libertathiest/fs10-atmega32u4-monitor/Assets/FS10-ATMEGA32U4-flyer.pdf

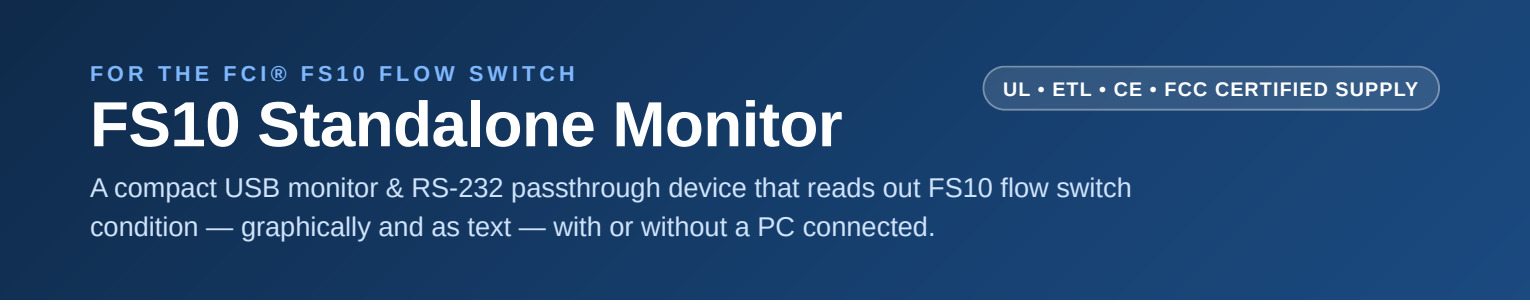
[picture p1: figure]
FS10 Standalone Monitor; UL • ETL • CE • FCC CERTIFIED SUPPLY
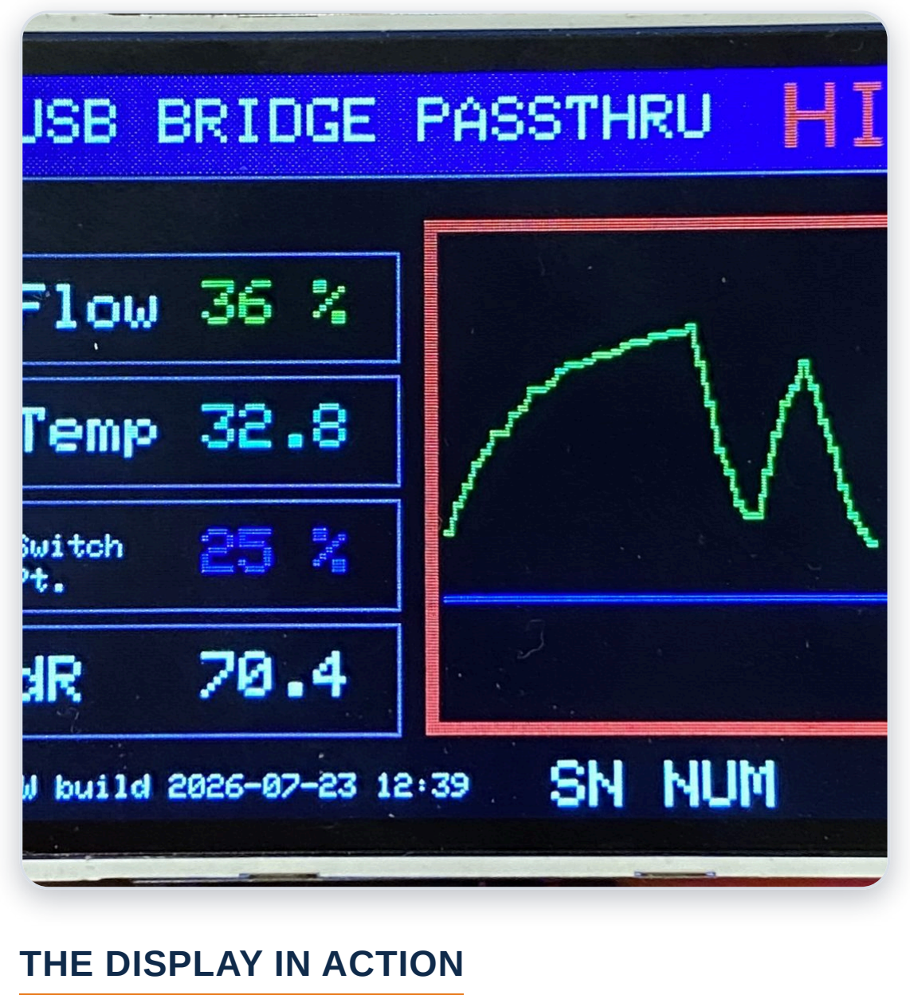
[picture p2: figure]
THE DISPLAY IN ACTION

## Live flow switch status, at a glance

A bright 2.4″ color display shows Flow%, Temperature, Switch Point, and dR as live numeric readouts plus a rolling trend graph — so techs can see switch behavior developing in real time, not just a pass/fail snapshot.

USB Bridge Passthru —
connects straight through to PCbased FS10 configuration &
monitoring software.

Stand-Alone Monitor mode — keeps reading and displaying flow status with no PC attached.

On-screen diagnostics — flags cable and communication faults directly on the display.

Drop-in replacement — works with existing FS10 flow switch wiring in the field.
Plug-and-play USB — no drivers to install, simple and field-proven design.

Field-tested — units already in daily use in customer support & field service roles.

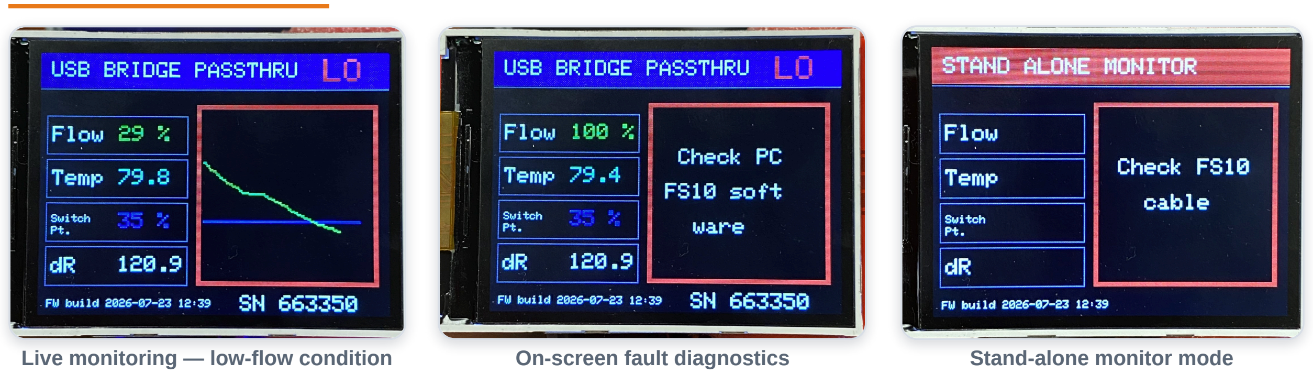
[picture p3: figure]
Live monitoring — low-flow condition; On-screen fault diagnostics; Stand-alone monitor mode
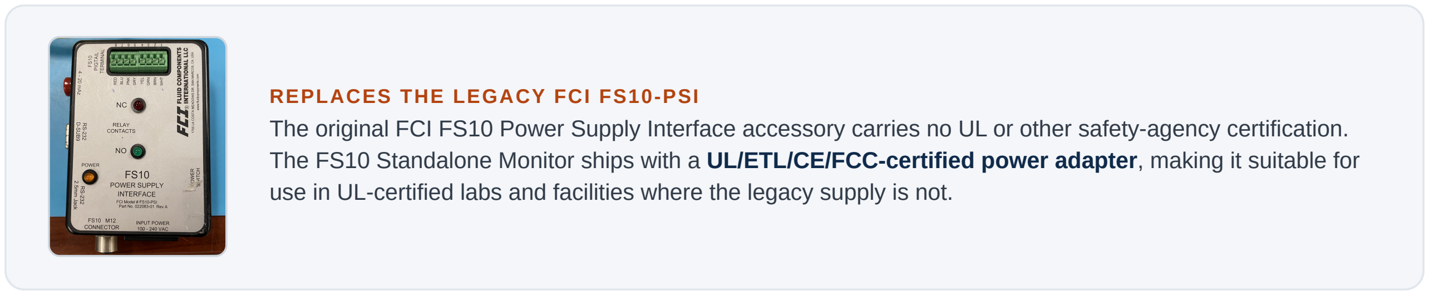
[picture p4: figure]
REPLACES THE LEGACY FCI FS10-PSI

The original FCI FS10 Power Supply Interface accessory carries no UL or other safety-agency certification. The FS10 Standalone Monitor ships with a UL/ETL/CE/FCC-certified power adapter, making it suitable for use in UL-certified labs and facilities where the legacy supply is not.

DISPLAY
2.4″ color TFT, 240×320

INTERFACE
Plug-and-play USB +
RS-232 passthrough

MODES
USB Bridge Passthru
& Stand-Alone Monitor

POWER ADAPTER
UL / ETL / CE / FCC
certified

COMPATIBILITY
FCI FS10 flow switch

F O R T H E F C I ® F S 1 0 F L O W S W I T C H

### A compact USB monitor & RS-232 passthrough device that reads out FS10 flow switch

condition — graphically and as text — with or without a PC connected.

Interested for your customers? Contact for pricing & availability.

### Jesse T

760‑497‑1816
