libertathiest/fs10-atmega32u4-monitor/archive/2026-08-24_fs10-tft/README.md

# FS10 TFT enclosure (retired)

`FS10-TFT-old.FCStd`, last saved 2026-08-24: the TFT-display enclosure that preceded the ATmega32U4
handheld. Archived 2026-11-03. No script reads it; the live design is
`hardware/FreeCAD enclosure/ATmega32U4-Enclosure.FCStd`, built by
`build_atmega32u4_enclosure.py`, and the generation between the two is in
`archive/2026-10-12_first-handheld/`.
