libertathiest/fs10-atmega32u4-monitor/Assets/FS10_front_label_rough_preview.png

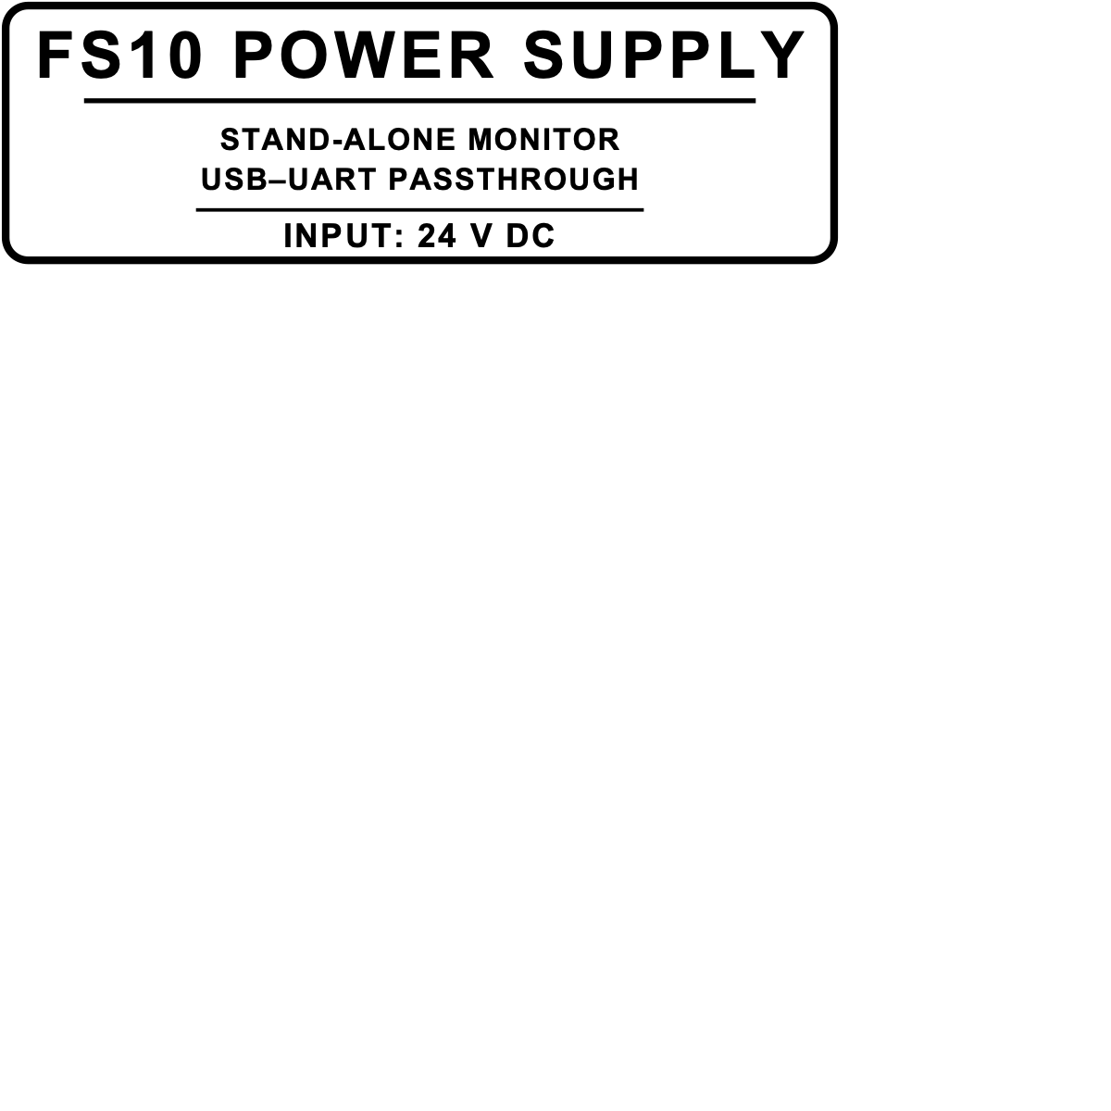
Assets/FS10_front_label_rough_preview.png
