libertathiest/fs10-atmega32u4-monitor/hardware/FS10--Hardware-KiCad/FS10-programmer-kicad-jlcpcb-bom.csv

Designator | Comment | Footprint | LCSC Part # | JLCPCB | Supplier Part | Manufacturer Part | Manufacturer | Description | Quantity | DNP
BZ1 | Buzzer_5V | Buzzer_Beeper:MagneticBuzzer_ProSignal_ABT-410-RC | C252917 | C252917 |  |  |  |  | 1
C1,C2,C8,C9,C11,C16,C21 | 100nF | Capacitor_SMD:C_0603_1608Metric | C14663 | C14663 | C14663 | CC0603KRX7R9BB104 | YAGEO | 100nF 50V X7R 0603 MLCC | 7
C4 | 10uF 50V | Capacitor_SMD:C_1210_3225Metric | C596319 | C596319 | C596319 | CC1210KKX7R9BB106 | YAGEO | 10uF 50V X7R 1210 MLCC | 1
C10,C25,C26 | 22uF | PCM_JLCPCB:C_1206 | C5672 | C5672 | C5672 | CL31A226KPHNNNE | Samsung Electro-Mechanics | 10V 22uF X5R ±10% 1206 Multilayer Ceramic Capacitors MLCC - SMD/SMT ROHS | 3
C13-C15,C17-C19 | 1uF | Capacitor_SMD:C_0603_1608Metric | C15849 | C15849 | C15849 | CL10A105KB8NNNC | Samsung Electro-Mechanics | 1uF 50V X5R 0603 MLCC | 6
C20 | 10u | Capacitor_Tantalum_SMD:CP_EIA-3528-21_Kemet-B | C2976904 | C2976904 | C2976904 | CA45A-B-20V-10UF-K | CEC(Shenzhen Zhenhua XinYun Elec) | 10uF 20V Case-B 3528 tantalum capacitor | 1
C22,C23 | 22pF | PCM_JLCPCB:C_0603 | C1653 | C1653 | C1653 | CL10C220JB8NNNC | Samsung Electro-Mechanics | 50V 22pF C0G ±5% 0603 Multilayer Ceramic Capacitors MLCC - SMD/SMT ROHS | 2
C24 | 100pF | PCM_JLCPCB:C_0603 | C14858 | C14858 | C14858 | CL10C101JB8NNNC | Samsung Electro-Mechanics | 100pF 50V C0G ±5% 0603 Multilayer Ceramic Capacitors MLCC - SMD/SMT ROHS | 1
CN1 | M12_8POS_PIGTAIL_TERMINATION | FS10-programmer-local:SIP-9_P2.54mm_Oval |  |  |  |  |  |  | 1 | DNP
D1 | SS34B | Diode_SMD:D_SMB | C13762 | C13762 | C13762 | SS34B | MDD | 3A 40V SMB Schottky diode for buck 5V isolation into +5V system rail | 1
D2 | SMBJ28A-TR | Diode_SMD:D_SMB | C96335 | C96335 | C96335 | SMBJ28A-TR | STMicroelectronics | 28V standoff, 45.4V clamp, 600W unidirectional SMB TVS for 24V raw input | 1
D3 | 1N4148W-TP | Diode_SMD:D_SOD-123 |  |  |  | 1N4148W-TP | MCC |  | 1
D4 | SP0503BAHTG | Package_TO_SOT_SMD:SOT-143 | C3040626 | C3040626 | C3040626 | SP0503BAHTG | TECH PUBLIC(台舟) | Polarity:Unidirectional Reverse Stand-Off Voltage (Vrwm):5.5V Clamping Voltage:14V Peak Pulse Current (Ipp):10A@8/20us Peak Pulse Power Dissipation (Ppp):150W@8/20us Voltage - Breakdown:6V Reverse Leakage Current (Ir):80nA Number of Channels:three routes | 1
D5 | US1A | PCM_JLCPCB:D_SMA | C18199125 | C18199125 | C18199125 | US1A | hongjiacheng | 1V@1A 50ns Independent Type 1A 50V SMA(DO-214AC) Fast Recovery / High Efficiency Diodes ROHS | 1
D6 | SS14 | Diode_SMD:D_SMA |  |  |  | SS14 |  | USB VBUS Schottky isolation into +5V system rail | 1
F1 | MF-MSMF050-2 | Fuse:Fuse_1812_4532Metric | C17313 | C17313 | C17313 | MF-MSMF050-2 | BOURNS | 500mA 15V 1812 resettable PTC fuse | 1
IC2 | AP63200WU-7 | Package_TO_SOT_SMD:TSOT-23-6 | C2071868 | C2071868 | C2071868 | AP63200WU-7 | Diodes Incorporated | 3.8V-32V input, adjustable 2A synchronous buck converter; feedback divider set above 5V to compensate D1 drop | 1
ICSP1 | ICSP | Connector_PinHeader_2.54mm:PinHeader_2x03_P2.54mm_Vertical |  |  |  |  | TE |  | 1 | DNP
J1 | DC005 | Connector_BarrelJack:BarrelJack_GCT_DCJ200-10-A_Horizontal | C5280493 | C5280493 | C5280493 | DC005 |  | DC barrel jack, switched, through-hole, hand/deselect assembly as needed | 1
J11 | Encoder module | Connector_PinHeader_2.54mm:PinHeader_1x05_P2.54mm_Vertical |  |  |  |  |  |  | 1
J12 | ILI9341 Display | Connector_PinHeader_2.54mm:PinHeader_1x10_P2.54mm_Vertical |  |  |  |  |  |  | 1
J13 | OLED_I2C_OPTION | Connector_PinHeader_2.54mm:PinHeader_1x04_P2.54mm_Vertical |  |  |  |  |  |  | 1 | Optional
L1 | 10uH | Inductor_SMD:L_Sunlord_SWPA5040S | C354610 | C354610 | C354610 | CKCS5040-10uH/M | CENKER | AP63200 buck inductor, shielded 10uH with saturation current above 2.5A | 1
L2 | MH2029-300Y | Inductor_SMD:L_0805_2012Metric |  |  |  | MH2029-300Y | Bourns |  | 1
LED1 | Wurth_WL-SFTW | PCM_LED_SMD_AKL:LED_RGB_Wuerth-PLCC4_3.2x2.8mm_150141M173100 |  |  |  |  |  |  | 1
LED2 | 5mm led hand-soldered | LED_THT:LED_D5.0mm-4_RGB |  |  |  |  |  |  | 1
Q_BZ1 | 2N7002 | Package_TO_SOT_SMD:SOT-23 | C28646312 | C28646312 | C28646312 |  |  | Low-side MOSFET driver for 5V magnetic buzzer | 1
R1,R14,R15 | 1kΩ | PCM_JLCPCB:R_0603 | C21190 | C21190 | C21190 | 0603WAF1001T5E | UNI-ROYAL(Uniroyal Elec) | 100mW Thick Film Resistors 75V ±100ppm/°C ±1% 1kΩ 0603 Chip Resistor - Surface Mount ROHS | 3
R2 | 100K | Resistor_SMD:R_0603_1608Metric | C25803 | C25803 | C25803 | 0603WAF1003T5E | UNI-ROYAL(Uniroyal Elec) | Resistance:100kΩ Package:0603 ±1% 100mW | 1
R3,R4 | 1M | Resistor_SMD:R_0603_1608Metric | C22935 | C22935 | C22935 | 0603WAF1004T5E | UNI-ROYAL(Uniroyal Elec) | Resistance:1MΩ Package:0603 ±1% 100mW | 2
R5,R6 | 22 | Resistor_SMD:R_0603_1608Metric | C23345 | C23345 | C23345 | 0603WAF220JT5E | UNI-ROYAL(Uniroyal Elec) | Resistance:22Ω Package:0603 ±1% 100mW | 2
R7 | 150k | Resistor_SMD:R_0603_1608Metric | C22807 | C22807 | C22807 | 0603WAF1503T5E | UNI-ROYAL(Uniroyal Elec) | Resistance:150kΩ Package:0603 ±1% 100mW | 1
R8 | 22k | Resistor_SMD:R_0603_1608Metric | C31850 | C31850 | C31850 | 0603WAF2202T5E | UNI-ROYAL(Uniroyal Elec) | Resistance:22kΩ Package:0603 ±1% 100mW | 1
R9 | 169K | Resistor_SMD:R_0603_1608Metric | C22817 | C22817 | C22817 | 0603WAF1693T5E | UNI-ROYAL(Uniroyal Elec) | Resistance:169kΩ Package:0603 ±1% 100mW | 1
R10 | 30K | Resistor_SMD:R_0603_1608Metric | C22984 | C22984 | C22984 | 0603WAF3002T5E | UNI-ROYAL(Uniroyal Elec) | Resistance:30kΩ Package:0603 ±1% 100mW | 1
R21 | 270Ω | PCM_JLCPCB:R_0805 | C17590 | C17590 | C17590 | 0805W8F2700T5E | UNI-ROYAL(Uniroyal Elec) | 125mW Thick Film Resistors 150V ±100ppm/°C ±1% 270Ω 0805 Chip Resistor - Surface Mount ROHS | 1
RESET1 | SKHHLUA010 | Button_Switch_THT:SW_Tactile_SKHH_Angled | C139764 | C139764 | C139764 | SKHHLUA010 | ALPSALPINE | Tactile Switch SPST-NO side actuated through-hole right angle, 6.2x6.2mm, 5.85mm stem, wave soldering | 1
R_BZ1 | 1k | Resistor_SMD:R_0805_2012Metric | C17513 | C17513 | C17513 | 0805W8F1001T5E | UNI-ROYAL(Uniroyal Elec) | Resistance:1kΩ Package:0805 ±1% 125mW | 1
R_BZ2 | 100k | Resistor_SMD:R_0805_2012Metric | C149504 | C149504 | C149504 | 0805W8F1003T5E | UNI-ROYAL(Uniroyal Elec) | Resistance:100kΩ Package:0805 ±1% 125mW | 1
SW1 | HX KCD11-BL | easyedatokicad:SW-TH_KCD11-BL | C6917329 | C6917329 | C6917329 | HX KCD11-BL | hanxia | SPST rocker switch, through-hole, hand/deselect assembly as needed | 1
SW2 | K2-1102SP-A4SC-04 | FS10-programmer:Push_Hybrid_SMD_THR_12x12mm | C83214 | C83214 | C83214 | K2-1102SP-A4SC-04 | Korean Hroparts Elec | 12x12mm SMD-4P SPST tactile switch, 7.5mm height | 1
TP1,TP2 |  | Connector_Pin:Pin_D0.9mm_L10.0mm_W2.4mm_FlatFork |  |  |  |  |  |  | 2
TP5-TP7 | TP | Connector_Wire:SolderWire-0.1sqmm_1x01_D0.4mm_OD1mm |  |  |  |  |  |  | 3
U2 | ATMEGA32U4-XUAU | Package_QFP:TQFP-44_10x10mm_P0.8mm | C44854 | C44854 | C44854 | ATMEGA32U4-AU | Microchip |  | 1
U3 | MAX232EIDR | Package_SO:SOIC-16_3.9x9.9mm_P1.27mm | C273639 | C273639 | C273639 | MAX232EIDR | TI(德州仪器) | Type:transceiver Number of Drivers:2 Number of Receivers:2 Data Rate:250Kbps Data Rate:250Kbps Voltage - Supply:4.5V~5.5V Voltage - Supply:4.5V~5.5V charge pump:Yes Operating Temperature:-40°C~+85°C Operating Temperature:-40°C~+85°C | 1
USB1 | USB-109C-B-CU | easyedatokicad:USB-B-TH_USB-109C-B-CU | C20611692 | C20611692 | C20611692 | USB-109C-B-CU | HOOYA | USB Type-B right-angle through-hole connector | 1
X1 | X322516MLB4SI | PCM_JLCPCB:OSC-SMD_4P-L3.2-W2.5-BL | C13738 | C13738 | C13738 | X322516MLB4SI | Yangxing Tech | 16MHz Surface Mount Crystal 9pF ±10ppm ±20ppm SMD3225-4P Crystals ROHS | 1
