libertathiest/fs10-atmega32u4-monitor/hardware/FreeCAD enclosure/ATmega32U4-Enclosure.step

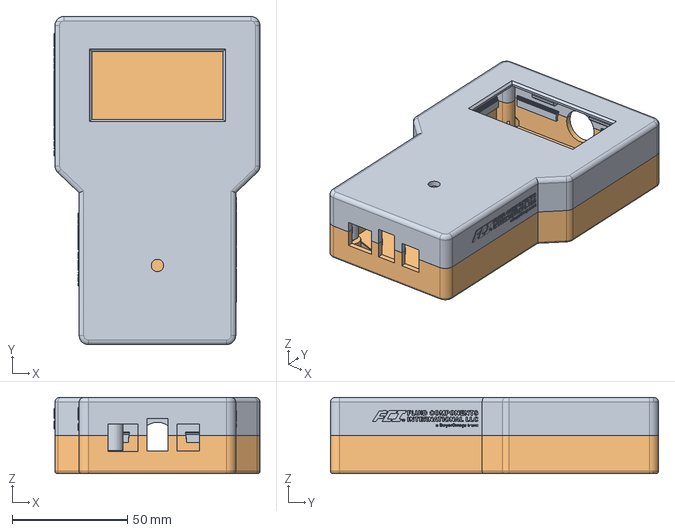
[picture p6: CAD file, 2026-11-04]
hardware/FreeCAD enclosure/ATmega32U4-Enclosure.step
89.4 x 142.4 x 33.0 mm
Front_Shell
Back_Shell
