libertathiest/fs10-atmega32u4-monitor/hardware/FS10--Hardware-KiCad/FS10-ATmega32U4-placement-reference.dxf

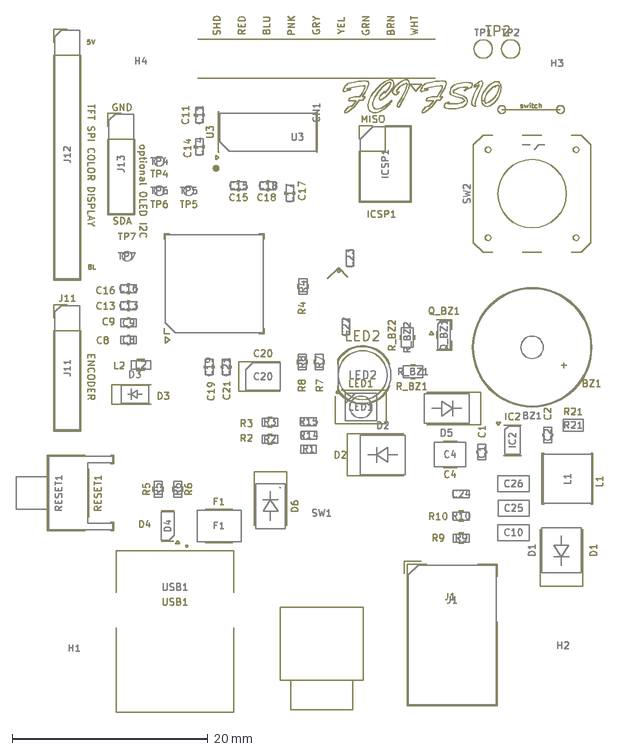
[picture p7: CAD file, 2026-08-29]
hardware/FS10--Hardware-KiCad/FS10-ATmega32U4-placement-reference.dxf
59.9 x 71.1 mm
