libertathiest/fs10-atmega32u4-monitor/hardware/FreeCAD enclosure/ATmega32U4-Enclosure-Board_model.step

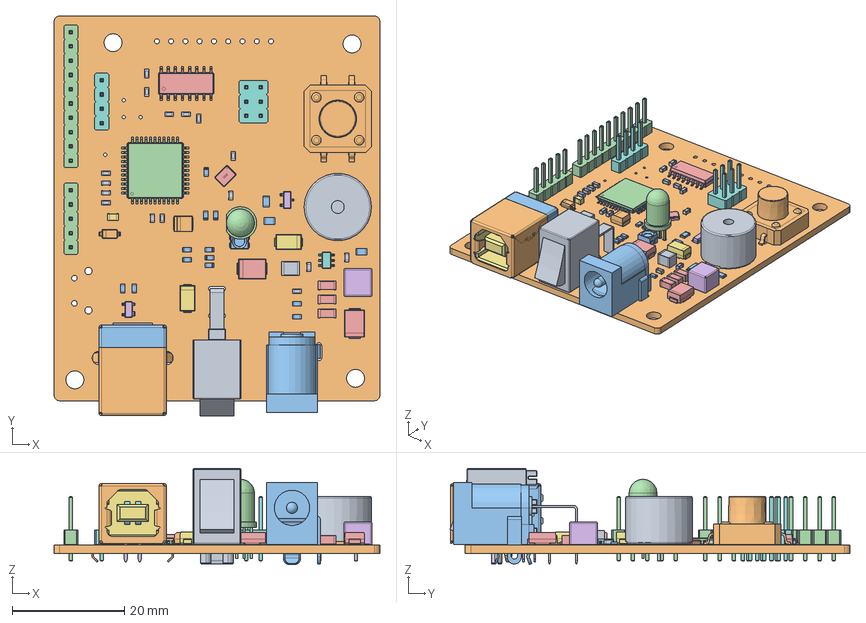
[picture p8: CAD file, 2026-11-04]
hardware/FreeCAD enclosure/ATmega32U4-Enclosure-Board_model.step
58.0 x 71.2 x 17.1 mm
