libertathiest/fs10-atmega32u4-monitor/hardware/FreeCAD enclosure/ATmega32U4-Enclosure-Front_Shell.step

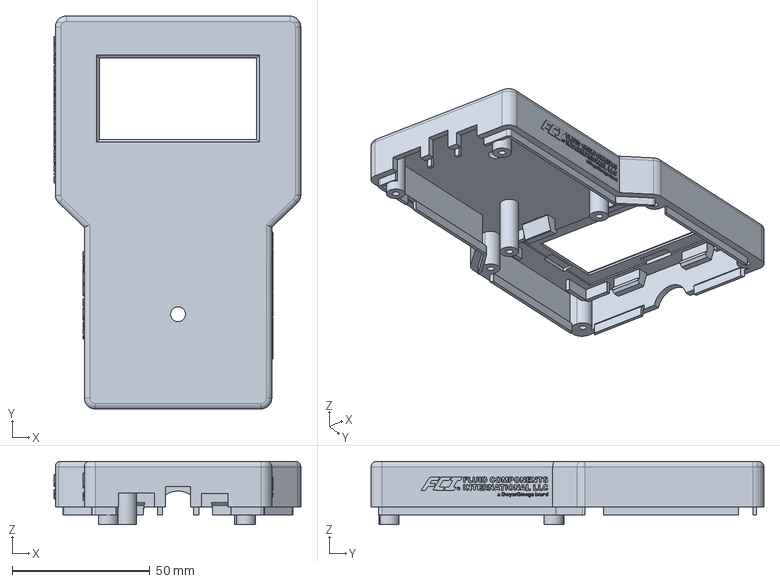
[picture p9: CAD file, 2026-11-04]
hardware/FreeCAD enclosure/ATmega32U4-Enclosure-Front_Shell.step
89.4 x 142.4 x 23.0 mm
