libertathiest/fs10-atmega32u4-monitor/hardware/FreeCAD enclosure/ATmega32U4-Enclosure-Back_Shell.step

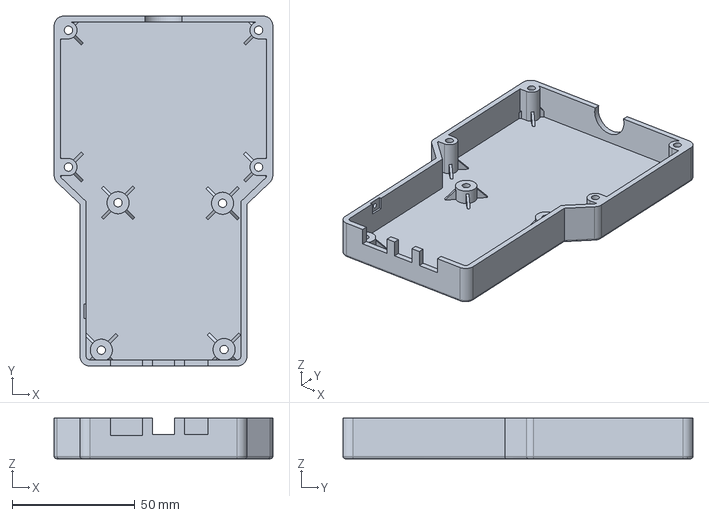
[picture p10: CAD file, 2026-11-04]
hardware/FreeCAD enclosure/ATmega32U4-Enclosure-Back_Shell.step
89.0 x 142.4 x 16.5 mm
