libertathiest/fs10-atmega32u4-monitor/hardware/FreeCAD enclosure/ATmega32U4-Enclosure-Window_Press_Tool.step

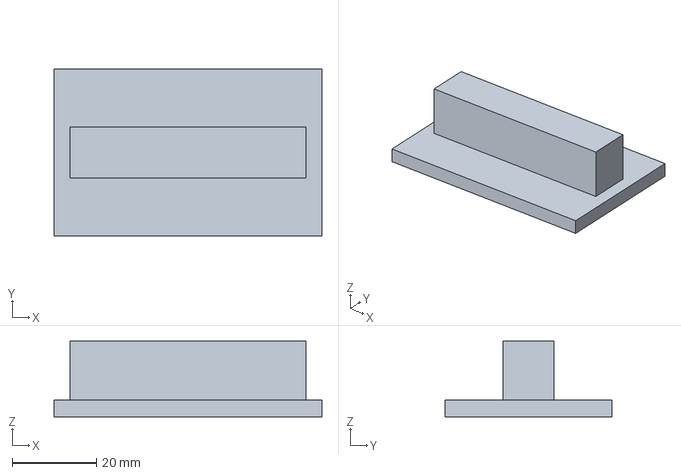
[picture p11: CAD file, 2026-11-04]
hardware/FreeCAD enclosure/ATmega32U4-Enclosure-Window_Press_Tool.step
63.6 x 39.6 x 18.0 mm
