libertathiest/fs10-atmega32u4-monitor/hardware/FreeCAD enclosure/ATmega32U4-Enclosure-Board_fitcheck.step

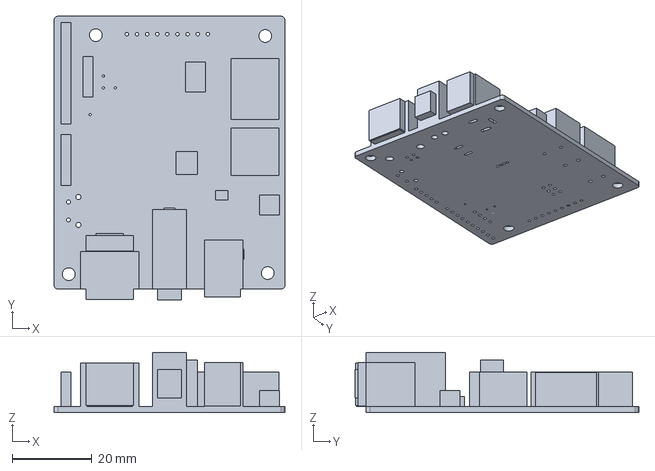
[picture p12: CAD file, 2026-11-04]
hardware/FreeCAD enclosure/ATmega32U4-Enclosure-Board_fitcheck.step
58.0 x 71.2 x 15.1 mm
