libertathiest/fs10-atmega32u4-monitor/archive/2026-08-24_fs10-tft/FS10-TFT-old.FCStd

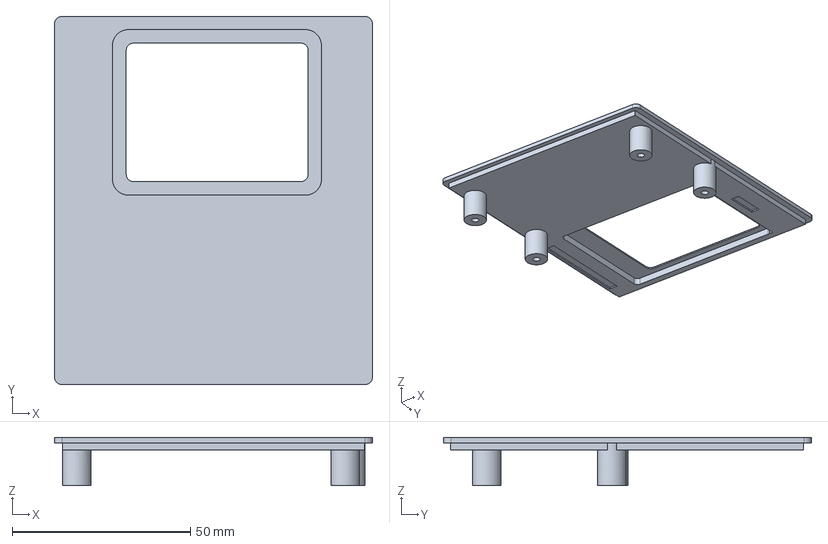
[picture p14: CAD file, 2026-08-29, an earlier design]
archive/2026-08-24_fs10-tft/FS10-TFT-old.FCStd
89.2 x 103.2 x 13.5 mm
