libertathiest/fs10-atmega32u4-monitor/archive/2026-10-12_first-handheld/ATmega32U4-Handheld-Back_Shell.step

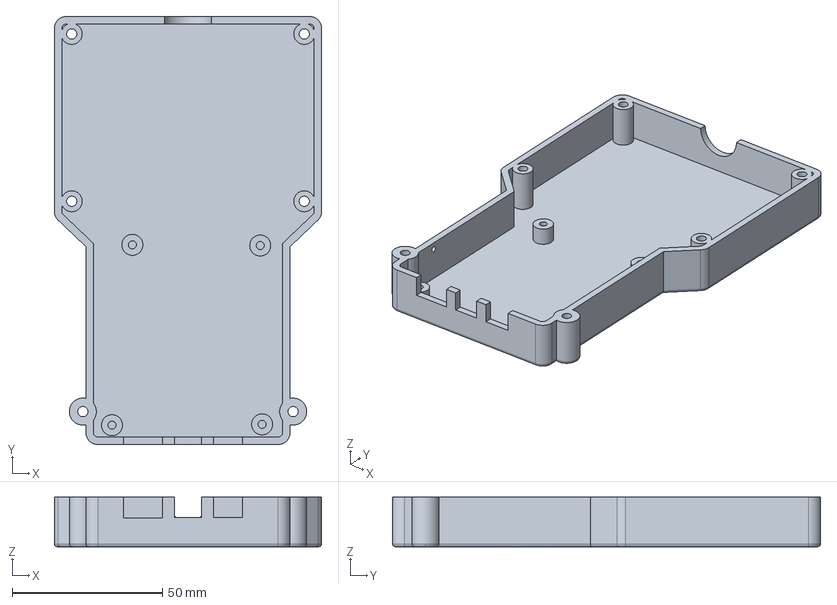
[picture p15: CAD file, 2026-11-04, an earlier design]
archive/2026-10-12_first-handheld/ATmega32U4-Handheld-Back_Shell.step
89.0 x 142.4 x 16.5 mm
