libertathiest/fs10-atmega32u4-monitor/archive/2026-10-12_first-handheld/ATmega32U4-Handheld.step

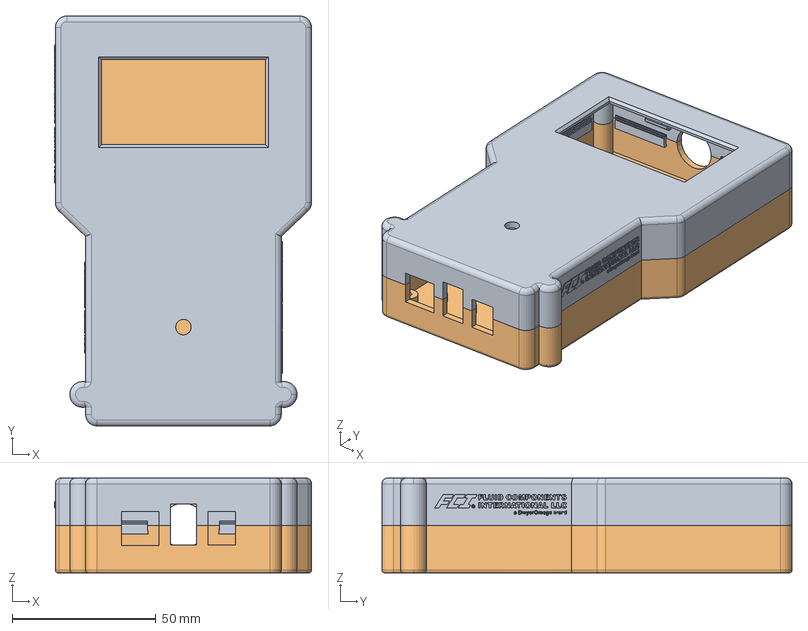
[picture p16: CAD file, 2026-11-04, an earlier design]
archive/2026-10-12_first-handheld/ATmega32U4-Handheld.step
89.3 x 142.4 x 33.0 mm
Front_Shell
Back_Shell
