libertathiest/fs10-atmega32u4-monitor/(list of files, cad)

Other CAD files:
hardware/FreeCAD enclosure/FS10-ATmega32U4.step
archive/2026-10-12_first-handheld/ATmega32U4-Handheld-Board_fitcheck.step
archive/2026-10-12_first-handheld/ATmega32U4-Handheld-Board_model.step
archive/2026-10-12_first-handheld/ATmega32U4-Handheld-Display_coupon.step
archive/2026-10-12_first-handheld/ATmega32U4-Handheld.FCStd
hardware/FreeCAD enclosure/ATmega32U4-Enclosure-Front_Shell.3mf
hardware/FreeCAD enclosure/ATmega32U4-Enclosure-Window_Press_Tool.3mf
hardware/FreeCAD enclosure/ATmega32U4-Enclosure.FCStd
