libertathiest/fs10-atmega32u4-monitor/Assets/FS10-ATmega32U4-schematic.pdf

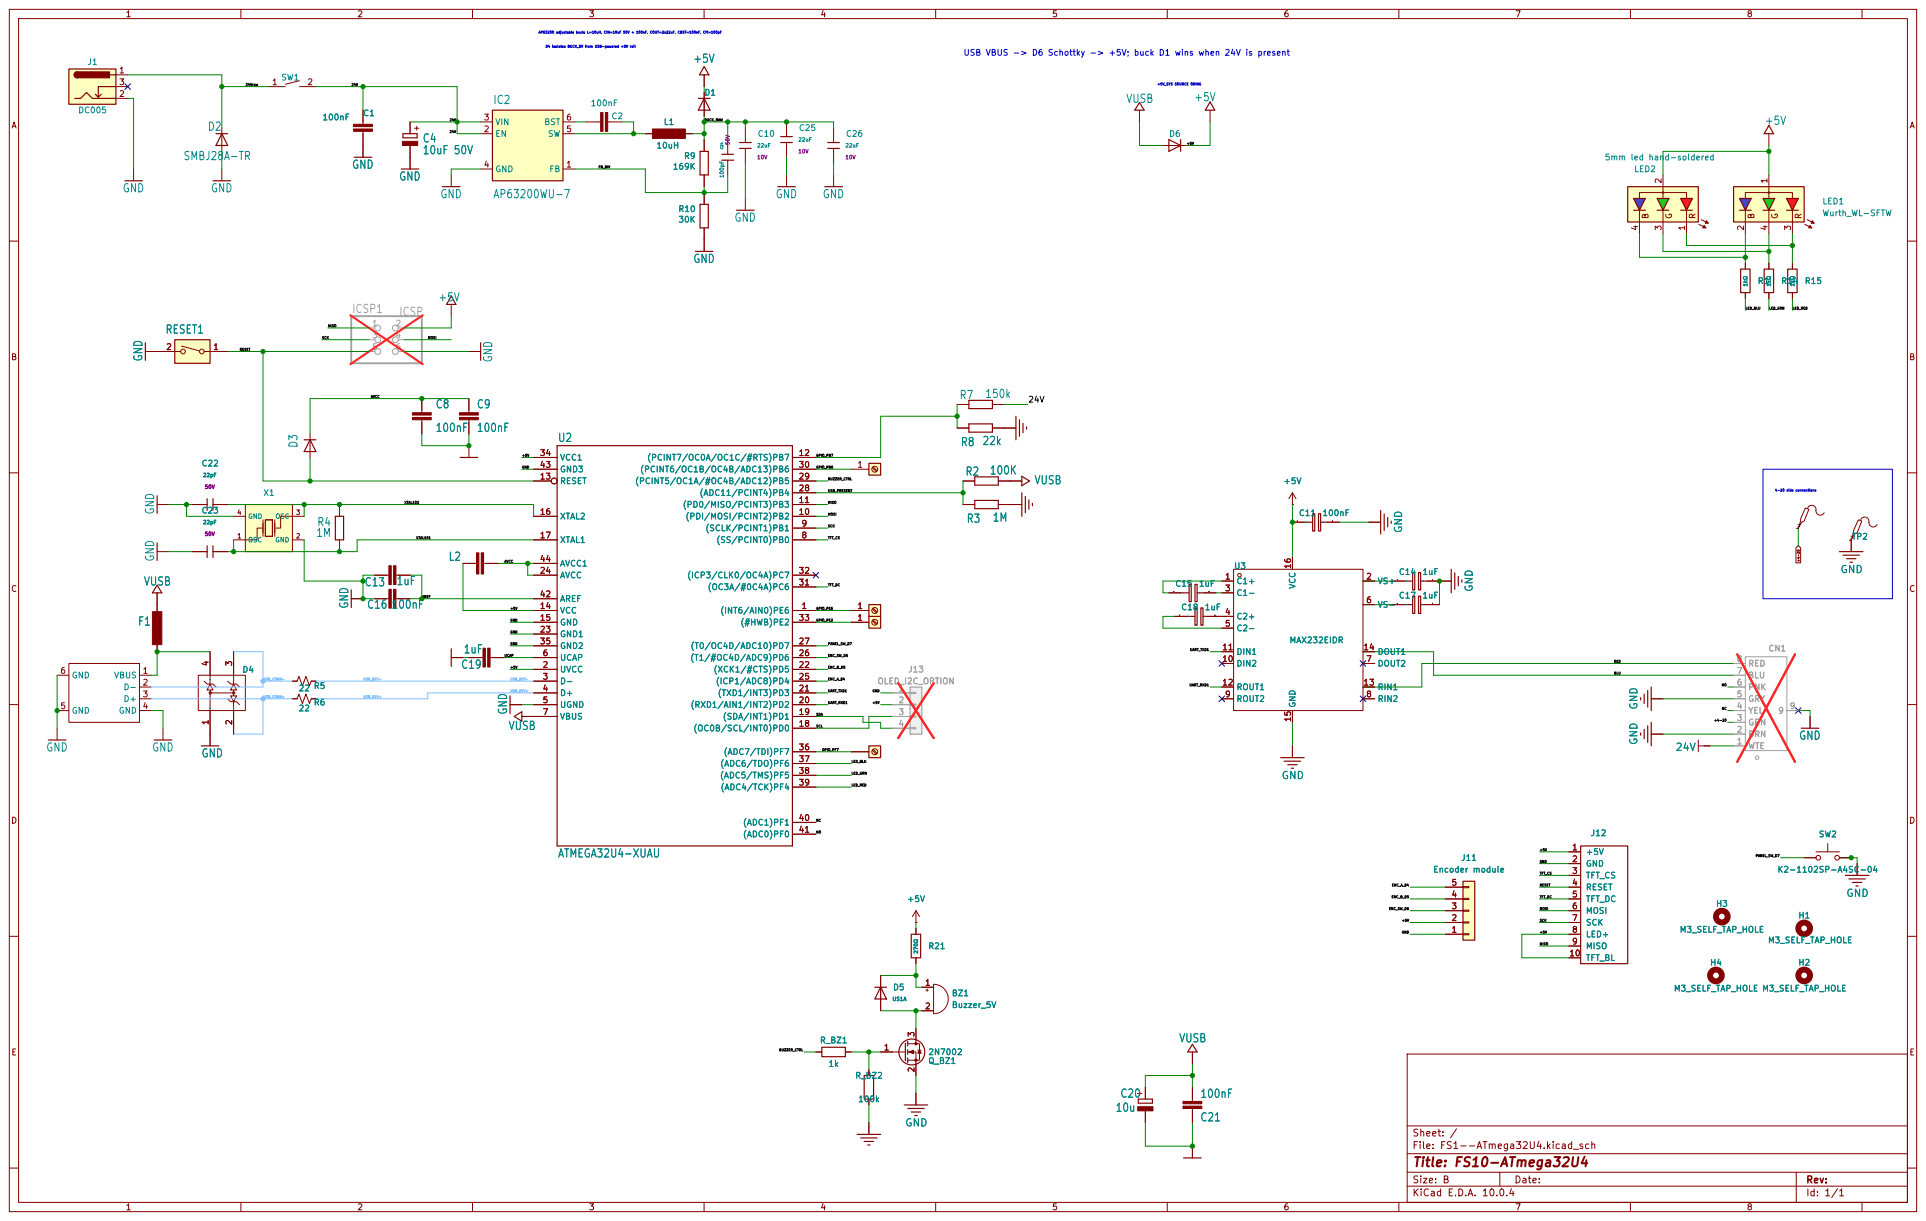
[picture p22: page 1]

D4 isolates BUCK_5V from USB-powered +5V rail AP63200 adjustable buck: L=10uH, CIN=10uF 50V + 100nF, COUT=2x22uF, CBST=100nF, Cff=100pF

Size: B | Rev:
KiCad E.D.A. 10.0.4 | Id: 1/1
