libertathiest/fs10-atmega32u4-monitor/Assets/FS10_polycarbonate_window_drawing.pdf

# FS10 POLYCARBONATE DISPLAY WINDOW

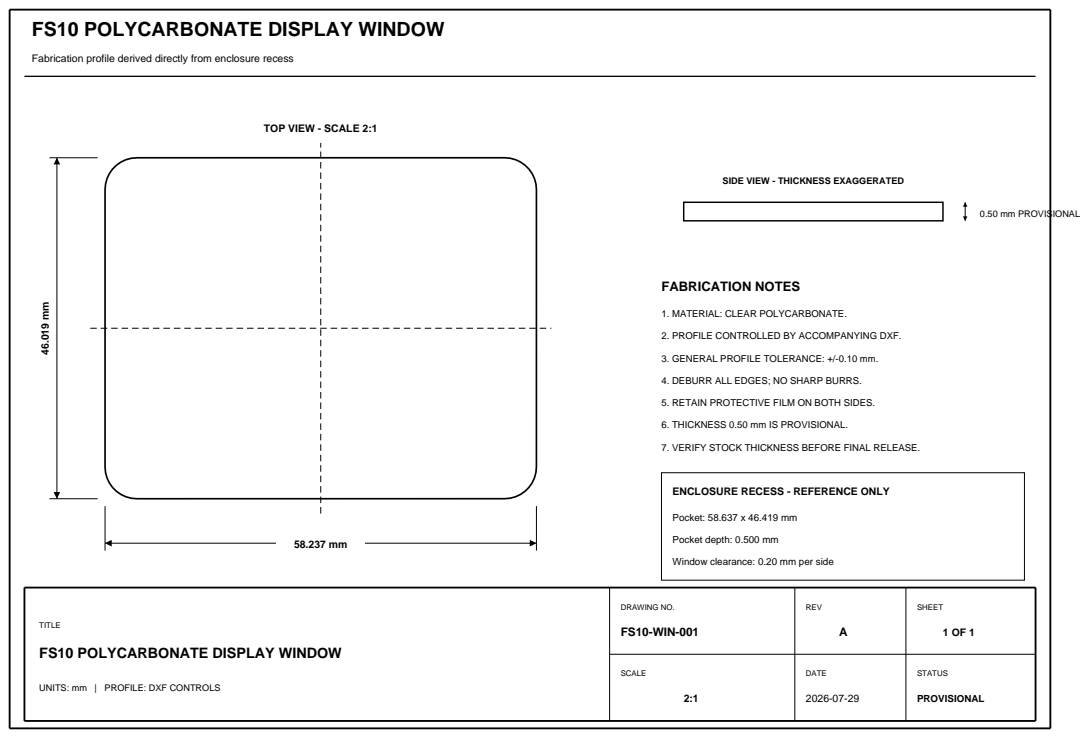
[picture p23: page 1]
0.50 mm PROVISIONAL; FABRICATION NOTES

Fabrication profile derived directly from enclosure recess

TOP VIEW - SCALE 2:1

SIDE VIEW - THICKNESS EXAGGERATED

1. MATERIAL: CLEAR POLYCARBONATE.

2. PROFILE CONTROLLED BY ACCOMPANYING DXF.

3. GENERAL PROFILE TOLERANCE: +/-0.10 mm.

4. DEBURR ALL EDGES; NO SHARP BURRS.

5. RETAIN PROTECTIVE FILM ON BOTH SIDES.

6. THICKNESS 0.50 mm IS PROVISIONAL.

7. VERIFY STOCK THICKNESS BEFORE FINAL RELEASE.

ENCLOSURE RECESS - REFERENCE ONLY

Pocket: 58.637 x 46.419 mm
Pocket depth: 0.500 mm
Window clearance: 0.20 mm per side

TITLE FS10 POLYCARBONATE DISPLAY WINDOW UNITS: mm | PROFILE: DXF CONTROLS | DRAWING NO. FS10-WIN-001 | REV A | SHEET 1 OF 1

SCALE 2:1 | DATE 2026-07-29 | STATUS PROVISIONAL
