libertathiest/fs10-atmega32u4-monitor/hardware/FS10--Hardware-KiCad/FS1--ATmega32U4.kicad_pcb

## KiCad design hardware/FS10--Hardware-KiCad/FS1--ATmega32U4.kicad_pcb (2026-08-29)

Schematic: FS1--ATmega32U4.kicad_sch, FS10-ATmega32U4

Parts:
BZ1: Buzzer_5V; MagneticBuzzer_ProSignal_ABT-410-RC; Mfg Part # ABT-410-RC; JLCPCB C252917
C1, C2, C11: 100nF; C_0603_1608Metric; Manufacturer Part CC0603KRX7R9BB104; JLCPCB C14663
C4: 10uF 50V; C_1210_3225Metric; Manufacturer Part CC1210KKX7R9BB106; JLCPCB C596319
C8, C9, C16, C21: 100nF; C_0603_1608Metric; Manufacturer Part CC0603KRX7R9BB104; Digikey_ref 399-C0603C104J4RAC7867CT-ND
C10, C25, C26: 22uF; C_1206; Voltage Rated 10V; Tolerance ±10%; Part CL31A226KPHNNNE; LCSC C5672
C13, C19: 1uF; C_0603_1608Metric; Manufacturer Part CL10A105KB8NNNC; Digikey_ref 399-C0603C105K4RAC7411CT-ND
C14, C15, C17, C18: 1uF; C_0603_1608Metric; Manufacturer Part CL10A105KB8NNNC; JLCPCB C15849
C20: 10u; CP_EIA-3528-21_Kemet-B; Manufacturer Part CA45A-B-20V-10UF-K; Digikey_ref 399-3708-1-ND
C22, C23: 22pF; C_0603; Voltage Rated 50V; Tolerance ±5%; Part CL10C220JB8NNNC; LCSC C1653
C24: 100pF; C_0603; Voltage Rated 50V; Tolerance ±5%; Part CL10C101JB8NNNC; LCSC C14858
CN1: M12_8POS_PIGTAIL_TERMINATION; SIP-9_P2.54mm_Oval; not fitted
D1: SS34B; D_SMB; Manufacturer Part SS34B; LCSC Part Name 3A 40V SMB Schottky diode for buck 5V i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
D2: SMBJ28A-TR; D_SMB; Manufacturer Part SMBJ28A-TR; LCSC Part Name 28V standoff, 45.4V clamp, 600W unidire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
D3: 1N4148W-TP; D_SOD-123; Manufacturer Part 1N4148W-TP; Digikey_ref 1N4148WTPMSCT-ND
D4: SP0503BAHTG; SOT-143; Manufacturer Part SP0503BAHTG; JLCPCB C3040626
D5: US1A; D_SMA; Forward Voltage (Vf@If) 1V@1A; Reverse Voltage (Vr) 50V; Manufacturer Part US1A; LCSC Part Name 1V@1A 50ns Independent Type 1A 50V SMA(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
D6: SS14; D_SMA; Manufacturer Part SS14; LCSC Part Name USB VBUS Schottky isolation into +5V sy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
F1: MF-MSMF050-2; Fuse_1812_4532Metric; Manufacturer Part MF-MSMF050-2; LCSC Part Name 500mA 15V 1812 resettable PTC fuse
H1, H2, H3, H4: M3_SELF_TAP_HOLE; MountingHole_3.2mm_M3
IC2: AP63200WU-7; TSOT-23-6; Manufacturer Part AP63200WU-7; LCSC Part Name 3.8V-32V input, adjustable 2A synchrono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
ICSP1: ICSP; PinHeader_2x03_P2.54mm_Vertical; Digikey_ref A128860-ND; not fitted
J1: DC005; BarrelJack_GCT_DCJ200-10-A_Horizontal; Manufacturer Part DC005; LCSC Part Name DC barrel jack, switched, through-hole,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
J11: Encoder module; PinHeader_1x05_P2.54mm_Vertical
J12: ILI9341 Display; PinHeader_1x10_P2.54mm_Vertical
J13: OLED_I2C_OPTION; PinHeader_1x04_P2.54mm_Vertical; not fitted
L1: 10uH; L_Sunlord_SWPA5040S; Manufacturer Part CKCS5040-10uH/M; JLCPCB C354610
L2: MH2029-300Y; L_0805_2012Metric; Manufacturer Part MH2029-300Y; Digikey_ref MH2029-300YCT-ND
LED1: Wurth_WL-SFTW; LED_RGB_Wuerth-PLCC4_3.2x2.8mm_150141M173100
LED2: 5mm led hand-soldered; LED_D5.0mm-4_RGB
Q_BZ1: 2N7002; SOT-23; LCSC Part Name Low-side MOSFET driver for 5V magnetic 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
R1, R14, R15: 1kΩ; R_0603; Overload Voltage (Max) 75V; Tolerance ±1%; Manufacturer Part 0603WAF1001T5E; LCSC Part Name 100mW Thick Film Resistors 75V ±100ppm/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
R2: 100K; R_0603_1608Metric; Manufacturer Part 0603WAF1003T5E; LCSC Part Name Resistance:100kΩ Package:0603 ±1% 100mW
R3, R4: 1M; R_0603_1608Metric; Manufacturer Part 0603WAF1004T5E; LCSC Part Name Resistance:1MΩ Package:0603 ±1% 100mW
R5, R6: 22; R_0603_1608Metric; Manufacturer Part 0603WAF220JT5E; LCSC Part Name Resistance:22Ω Package:0603 ±1% 100mW
R7: 150k; R_0603_1608Metric; Manufacturer Part 0603WAF1503T5E; LCSC Part Name Resistance:150kΩ Package:0603 ±1% 100mW
R8: 22k; R_0603_1608Metric; Manufacturer Part 0603WAF2202T5E; LCSC Part Name Resistance:22kΩ Package:0603 ±1% 100mW
R9: 169K; R_0603_1608Metric; Manufacturer Part 0603WAF1693T5E; LCSC Part Name Resistance:169kΩ Package:0603 ±1% 100mW
R10: 30K; R_0603_1608Metric; Manufacturer Part 0603WAF3002T5E; LCSC Part Name Resistance:30kΩ Package:0603 ±1% 100mW
R21: 270Ω; R_0805; Overload Voltage (Max) 150V; Tolerance ±1%; Manufacturer Part 0805W8F2700T5E; LCSC Part Name 125mW Thick Film Resistors 150V ±100ppm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
RESET1: SKHHLUA010; SW_Tactile_SKHH_Angled; Manufacturer Part SKHHLUA010; LCSC C139764
R_BZ1: 1k; R_0805_2012Metric; Manufacturer Part 0805W8F1001T5E; LCSC Part Name Resistance:1kΩ Package:0805 ±1% 125mW
R_BZ2: 100k; R_0805_2012Metric; Manufacturer Part 0805W8F1003T5E; LCSC Part Name Resistance:100kΩ Package:0805 ±1% 125mW
SW1: HX KCD11-BL; SW-TH_KCD11-BL; Manufacturer Part HX KCD11-BL; JLCPCB C6917329
SW2: K2-1102SP-A4SC-04; Push_Hybrid_SMD_THR_12x12mm; Manufacturer Part K2-1102SP-A4SC-04; LCSC Part Name 12x12mm SMD-4P SPST tactile switch, 7.5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
TP1, TP2: Pin_D0.9mm_L10.0mm_W2.4mm_FlatFork
TP4, TP5, TP6, TP7: TP; SolderWire-0.1sqmm_1x01_D0.4mm_OD1mm
U2: ATMEGA32U4-XUAU; TQFP-44_10x10mm_P0.8mm; Manufacturer Part ATMEGA32U4-AU; JLCPCB C44854
U3: MAX232EIDR; SOIC-16_3.9x9.9mm_P1.27mm; Manufacturer Part MAX232EIDR; JLCPCB C273639
USB1: USB-109C-B-CU; USB-B-TH_USB-109C-B-CU; Manufacturer Part USB-109C-B-CU; JLCPCB C20611692
X1: X322516MLB4SI; OSC-SMD_4P-L3.2-W2.5-BL; Frequency Tolerance ±10ppm; Manufacturer Part X322516MLB4SI; LCSC Part Name 16MHz Surface Mount Crystal 9pF ±10ppm 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

Connections:
24V: C1.1, C4.1 (+), CN1.1 (WTE), IC2.2 (EN), IC2.3 (VIN), R7.1, SW1.2
+4-20: CN1.3 (GRN), TP1.1 (1_1)
+5V: C11.2, D1.1 (C), D6.1 (C), ICSP1.2, J11.2, J12.1 (+5V), J12.8 (LED+), J12.10 (TFT_BL), J13.2, L2.2, LED1.1 (A), LED2.2 (A), R21.1, U2.2 (UVCC), U2.14 (VCC), U2.34 (VCC1), U3.16 (VCC)
/24Vraw: D2.1 (C), J1.1, SW1.1
/AREF: C13.2, C16.2, U2.42 (AREF)
/AVCC: C8.1, C9.1, D3.1 (C), L2.1, U2.24 (AVCC), U2.44 (AVCC1)
/BLU: CN1.7 (BLU), U3.14 (DOUT1)
/BUCK_RAW: C10.1, C24.1, C25.1, C26.1, D1.2 (A), L1.2, R9.2
/BUZZER_CTRL: R_BZ1.1, U2.29 ((PCINT5/OC1A/#OC4B/ADC12)PB5)
/ENC_A_D4: J11.5, U2.25 ((ICP1/ADC8)PD4)
/ENC_B_D5: J11.4, U2.22 ((XCK1/#CTS)PD5)
/ENC_SW_D6: J11.3, U2.26 ((T1/#OC4D/ADC9)PD6)
/FB_DIV: C24.2, IC2.1 (FB), R9.1, R10.2
/GPIO_PB6: TP4.1 (Pin_1_1), U2.30 ((PCINT6/OC1B/OC4B/ADC13)PB6)
/GPIO_PB7: R7.2, R8.2, U2.12 ((PCINT7/OC0A/OC1C/#RTS)PB7)
/GPIO_PE2: TP6.1 (Pin_1_1), U2.33 ((#HWB)PE2)
/GPIO_PE6: TP5.1 (Pin_1_1), U2.1 ((INT6/AIN0)PE6)
/GPIO_PF7: TP7.1 (Pin_1_1), U2.36 ((ADC7/TDI)PF7)
/LED_BLU: R1.2, U2.37 ((ADC6/TDO)PF6)
/LED_GRN: R14.2, U2.38 ((ADC5/TMS)PF5)
/LED_RED: R15.2, U2.39 ((ADC4/TCK)PF4)
/MISO: ICSP1.1, J12.9 (MISO), U2.11 ((PD0/MISO/PCINT3)PB3)
/MOSI: ICSP1.4, J12.6 (MOSI), U2.10 ((PDI/MOSI/PCINT2)PB2)
/NC: CN1.4 (YEL), U2.40 ((ADC1)PF1)
/NO: CN1.6 (PNK), U2.41 ((ADC0)PF0)
/PANEL_SW_D7: SW2.1, U2.27 ((T0/OC4D/ADC10)PD7)
/RED: CN1.8 (RED), U3.13 (RIN1)
/RESET: D3.2 (A), ICSP1.5, J12.4 (RESET), RESET1.1, U2.13 (RESET)
/SCK: ICSP1.3, J12.7 (SCK), U2.9 ((SCLK/PCINT1)PB1)
/SCL: J13.3, U2.18 ((OC0B/SCL/INT0)PD0)
/SDA: J13.4, U2.19 ((SDA/INT1)PD1)
/TFT_CS: J12.3 (TFT_CS), U2.8 ((SS/PCINT0)PB0)
/TFT_DC: J12.5 (TFT_DC), U2.31 ((OC3A/#0C4A)PC6)
/UART_RXD1: U2.20 ((RXD1/AIN1/INT2)PD2), U3.12 (ROUT1)
/UART_TXD1: U2.21 ((TXD1/INT3)PD3), U3.11 (DIN1)
/UCAP: C19.2, U2.6 (UCAP)
/USB_CONN+: D4.2, R6.1, USB1.3 (D+)
/USB_CONN-: D4.3, R5.1, USB1.2 (D-)
/USB_DEV+: R6.2, U2.4 (D+)
/USB_DEV-: R5.2, U2.3 (D-)
/USB_PRESENT: R2.2, R3.2, U2.28 ((ADC11/PCINT4)PB4)
/XTAL101: C23.2, R4.1, U2.17 (XTAL1), X1.1 (OSC)
/XTAL102: C22.2, R4.2, U2.16 (XTAL2), X1.3 (OSC)
GND: C1.2, C4.2 (-), C8.2, C9.2, C10.2, C11.1, C13.1, C14.1, C16.1, C17.1, C19.1, C20.2 (-), C21.1, C22.1, C23.1, C25.2, C26.2, CN1.2 (BRN), CN1.5 (GRY), CN1.9, D2.2 (A), D4.1, IC2.4 (GND), ICSP1.6, J1.2, J11.1, J12.2 (GND), J13.1, Q_BZ1.2 (S), R3.1, R8.1, R10.1, RESET1.2, R_BZ2.2, SW2.2, TP2.1 (1_1), U2.5 (UGND), U2.15 (GND), U2.23 (GND1), U2.35 (GND2), U2.43 (GND3), U3.15 (GND), USB1.4 (GND), USB1.5 (GND), USB1.6 (GND), X1.2 (GND), X1.4 (GND)
unnamed: BZ1.1 (+), D5.1, R21.2
unnamed: BZ1.2 (-), D5.2, Q_BZ1.3 (D)
unnamed: C2.2, IC2.6 (BST)
unnamed: C2.1, IC2.5 (SW), L1.1
unnamed: LED1.2 (B), LED2.4 (B), R1.1
unnamed: LED1.4 (G), LED2.3 (G), R14.1
unnamed: LED1.3 (R), LED2.1 (R), R15.1
unnamed: Q_BZ1.1 (G), R_BZ1.2, R_BZ2.1
unnamed: C15.2, U3.1 (C1+)
unnamed: C15.1, U3.3 (C1−)
unnamed: C18.1, U3.4 (C2+)
unnamed: C18.2, U3.5 (C2−)
unnamed: C14.2, U3.2 (VS+)
unnamed: C17.2, U3.6 (VS−)
unnamed: D4.4, F1.2, USB1.1 (VBUS)
VUSB: C20.1 (+), C21.2, D6.2 (A), F1.1, R2.1, U2.7 (VBUS)

Notes on the sheet:
D4 isolates BUCK_5V from USB-powered +5V rail
AP63200 adjustable buck: L=10uH, CIN=10uF 50V + 100nF, COUT=2x22uF, CBST=100nF, Cff=100pF
USB VBUS -> D6 Schottky -> +5V; buck D1 wins when 24V is present
4-20 side connections
+5V_SYS SOURCE ORING

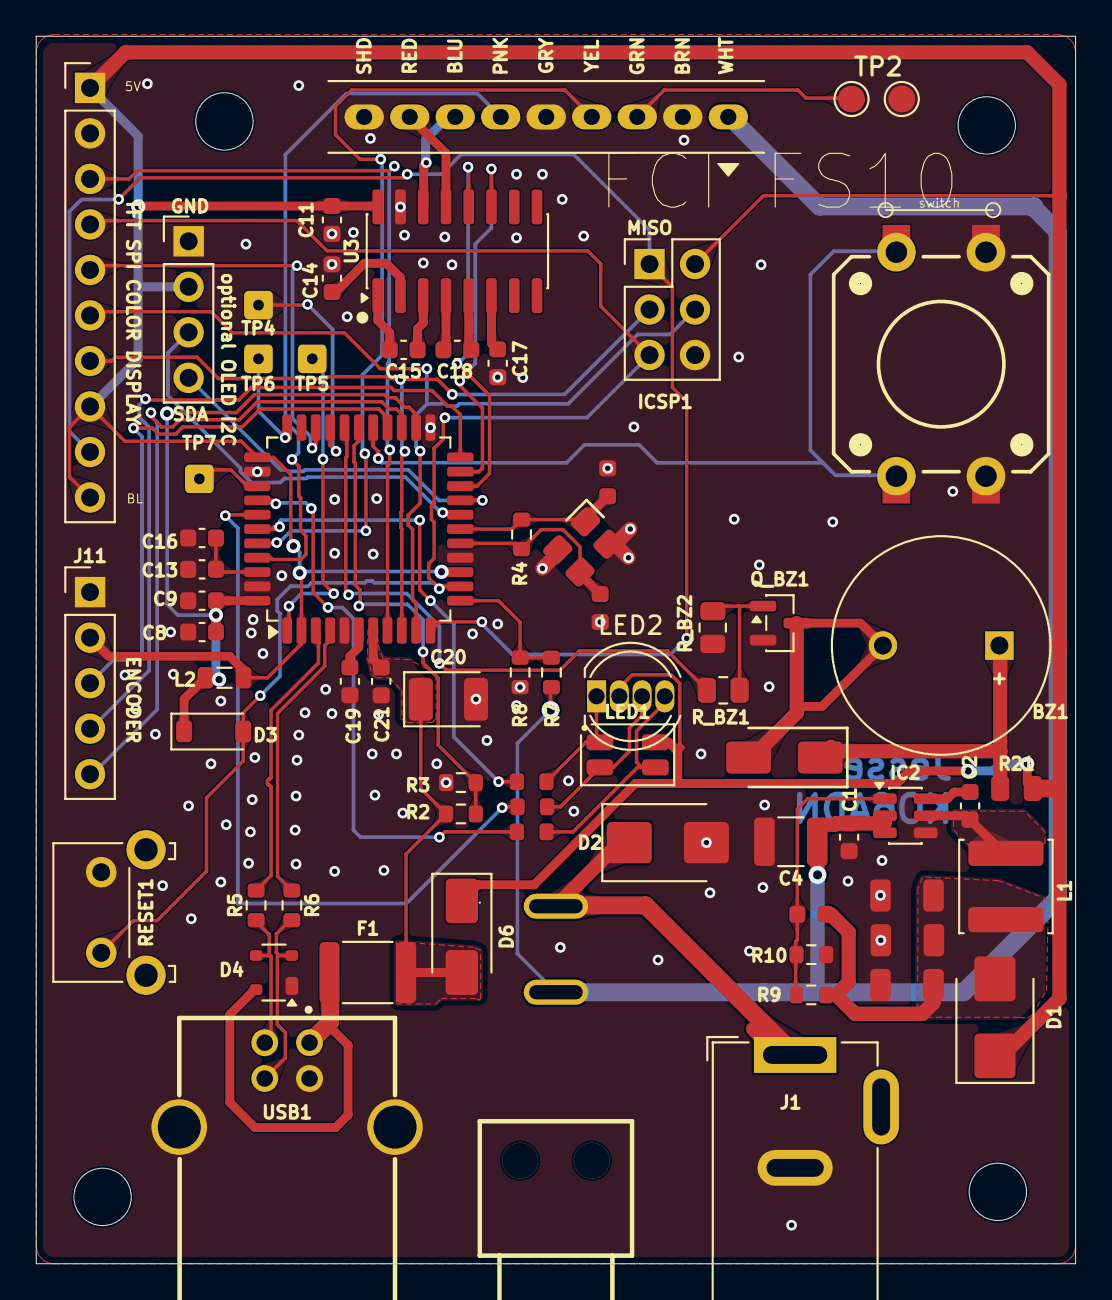
[picture p24: board FS1--ATmega32U4.kicad_pcb from above]

Board: 2 copper layers, 58.0 x 68.5 mm, 73 parts (0 on the bottom side), 60 nets.
