libertathiest/fs10-atmega32u4-monitor/(commit log)

2026-08-29 Initial commit: FS10 ATmega32U4 standalone monitor
    [FS1--ATmega32U4.kicad_pcb, FS1--ATmega32U4.kicad_sch, FS10-ATmega32U4-placement-reference.dxf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]
2026-10-12 Enclosure v2: stiff 4-clip display hold, shared board/case screws, no grip ears
    Old handheld scripts archived to archive/2026-10-12_first-handheld.
2026-11-04 Enclosure: M12 down 2.7 mm, and the bench work it was sitting on
    MDC_Z_OFFSET goes to -2.7, with a sheet migration from 0. The user placed the
    M12 reference in the model and that is where it landed: the connector's centre
    moves from z 8.00, the parting line, down to 5.30. The contacts follow it now
    - they had been left behind at 7.88 when only the body was dragged - because
    both are built from mdc_z.
    The rest of this file is work in progress that was already here, uncommitted,
    from 2026-10-30: the two-line build stamp, PCB_BOSS_D 7 -> 9 with gusset fins,
    display screw pillars in place of the snap clips, and the polycarbonate press
    tool. Committed together so the file is recorded rather t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
2026-11-04 Enclosure: track the model, its exports and the inputs the build needs
    The design being printed from existed only on disk: ATmega32U4-Enclosure.FCStd,
    its ten STEP and 3mf exports, and the two files the build imports every run -
    FS10-ATmega32U4.step as the board model and FCI_logo_emboss.brep. None of it
    was recoverable from this repository.
    Also drops three files that had been deleted on disk but not in git: the old
    parametric FCStd, STL/lid.stl and notes/mermaid-diagram.svg.
    __pycache__ and *.pyc are ignored rather than tracked - the FreeCAD scripts
    leave bytecode next to themselves.
    Assets/FS10_Financial_Summary.docx stays untracked, deliberately: this
    repository has a GitHub remote a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
    [ATmega32U4-Enclosure-Back_Shell.step, ATmega32U4-Enclosure-Board_fitcheck.step, ATmega32U4-Enclosure-Board_model.step, ATmega32U4-Enclosure-Display_coupon.step, ATmega32U4-Enclosure-Front_Shell.3mf, ATmega32U4-Enclosure-Front_Shell.step, ATmega32U4-Enclosure-Window_Press_Tool.3mf, ATmega32U4-Enclosure-Window_Press_Tool.step]
2026-11-04 Track the rest of the project: archives, firmware, KiCad, notes
    Everything left on disk and outside git, so the repository holds the project
    rather than part of it:
    - archive/2026-08-24_fs10-tft and archive/2026-10-12_first-handheld, the two
    retired generations, each with the README written when they were put away
    - firmware/FS10_ATMEGA32U4-OLED
    - the KiCad sources: schematic, board, project, placement DXF and the two
    JLCPCB CSVs
    - the print and assembly notes PDF, and Assets/FS10_front_label.svg
    The financial summary and BOM-JLCPCB-cost.xls stay out - they were already
    listed in .gitignore, lines 12 to 14, and this repository has a GitHub remote.
    Left alone: an empty stray file in th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
    [ATmega32U4-Handheld-Back_Shell.step, ATmega32U4-Handheld-Board_fitcheck.step, ATmega32U4-Handheld-Board_model.step, ATmega32U4-Handheld-Display_coupon.step, ATmega32U4-Handheld-Front_Shell.step, ATmega32U4-Handheld.FCStd, ATmega32U4-Handheld.step, FS10-TFT-old.FCStd]
